ToVuKhoiNguyen/Smart-Crop-Care-System/Nháp.docx

Hệ thống giám sát và điều khiển nông nghiệp sử dụng năng lượng mặt trời và IoT hoạt động dựa trên hai nguồn năng lượng chính: adapter cấp nguồn cho Gateway và pin mặt trời cung cấp năng lượng cho các node cảm biến và node điều khiển. Các node này sử dụng pin Li-ion 18650 được sạc qua mạch sạc CN3791 từ tấm pin mặt trời. Các thành phần tiêu thụ năng lượng chính là vi điều khiển ESP32, cảm biến, mô-đun LoRa, và OLED ở node cảm biến, cùng với relay ở node điều khiển. Hệ thống áp dụng chế độ deep sleep, giúp tiết kiệm năng lượng khi không hoạt động, giảm dòng tiêu thụ xuống dưới 3mA.

Node cảm biến tiêu thụ năng lượng qua các trạng thái như deep sleep (dưới 100 µA), đo đạc (20–80 mA), truyền tin LoRa (120–140 mA), và chờ ACK (10–20 mA), trong khi node điều khiển có mức tiêu thụ năng lượng cao hơn do hoạt động của relay, với dòng tiêu thụ lên đến 70–90 mA khi bật. Gateway là thành phần duy nhất sử dụng nguồn điện liên tục, với mức tiêu thụ ổn định từ 100–120 mA để duy trì hoạt động của các thành phần như ESP32, LoRa, và màn hình TFT.

Để tối ưu hóa năng lượng, hệ thống áp dụng các chiến lược như chế độ ngủ và chu kỳ đánh thức định kỳ, đồng thời điều chỉnh thời gian ngủ dựa trên mức điện áp còn lại của pin. Vào ban ngày, khi có ánh sáng mặt trời, chu kỳ ngủ của node cảm biến ngắn hơn (10 phút) để cập nhật dữ liệu thường xuyên, trong khi vào ban đêm hoặc khi pin yếu, chu kỳ ngủ sẽ dài hơn (30–60 phút). Hệ thống cũng sử dụng cơ chế tính toán phần trăm pin còn lại dựa trên điện áp đo được và điều chỉnh thời gian ngủ phù hợp để đảm bảo hoạt động ổn định trong điều kiện thiếu sáng.

Tấm pin mặt trời được chọn có công suất từ 3W đến 6W, đủ để sạc pin cho hệ thống ngay cả khi ánh sáng không lý tưởng. Pin lưu trữ cần có dung lượng từ 2700 mAh đến 3600 mAh để duy trì hoạt động trong khoảng 30 ngày không có ánh sáng mặt trời. Đối với việc gửi dữ liệu, mỗi node đánh thức định kỳ và gửi gói tin qua LoRa, đồng thời chờ phản hồi ACK từ Gateway. Nếu không nhận được phản hồi, node sẽ gửi lại tối đa 10 lần, cách nhau 5 giây. Cơ chế này giúp đảm bảo độ tin cậy trong truyền dữ liệu mà không gây lãng phí năng lượng quá mức.

Dựa trên Chương 3 và Chương 4 của tài liệu, dưới đây là nguyên lý hoạt động, thí nghiệm, kết quả và thảo luận theo định dạng báo cáo khoa học:

BÁO CÁO NGHIÊN CỨU: HỆ THỐNG CUNG CẤP VÀ QUẢN LÝ NĂNG LƯỢNG ĐIỆN CHO MẠNG ĐA CẢM BIẾN GIÁM SÁT CÂY TRỒNG SỬ DỤNG PIN MẶT TRỜI

I. Nguyên lý hoạt động

Hệ thống được thiết kế nhằm cung cấp và quản lý năng lượng hiệu quả cho mạng cảm biến giám sát cây trồng, sử dụng năng lượng mặt trời để đảm bảo hoạt động độc lập và bền vững. Nguyên lý hoạt động tập trung vào việc tối ưu hóa tiêu thụ năng lượng thông qua quản lý nguồn cấp, các chế độ hoạt động của vi điều khiển và chiến lược truyền nhận dữ liệu.

1. Cung cấp năng lượng bằng pin mặt trời:
  - Nguồn cấp: Các node cảm biến và node điều khiển hoạt động độc lập bằng pin sạc Li-ion 18650, được nạp điện từ tấm pin mặt trời đơn tinh thể (công suất tối đa khoảng 4.08W, điện áp ra 6-7V) thông qua mạch sạc CN3791 tích hợp MPPT phần cứng. Gateway sử dụng nguồn adapter 12V liên tục.
  - Chuyển đổi nguồn: Để tối ưu hiệu suất, các bộ ổn áp tuyến tính (LDO) như RT9080 và IC TLV62569 được lựa chọn cho node cảm biến nhờ dòng tĩnh thấp và hiệu suất cao. Node điều khiển sử dụng MP2451 và 7805.
  - Bảo vệ pin: Mạch bảo vệ DW01A và FS8205 được tích hợp để chống xả quá mức, quá dòng và ngắn mạch cho pin Li-ion, đảm bảo tuổi thọ và an toàn cho hệ thống.
2. Phân tích và tối ưu tiêu thụ năng lượng theo trạng thái hoạt động:
  - Các trạng thái hoạt động: Node cảm biến có bốn giai đoạn chính: ngủ sâu (deep sleep), đo lường, truyền tin (Tx) và chờ xác nhận (Rx). Node điều khiển tương tự nhưng có thêm giai đoạn kích hoạt tải (relay).
  - Tiết kiệm năng lượng:
    - Deep sleep: ESP32 được đưa vào chế độ ngủ sâu, chỉ duy trì bộ đếm thời gian thực (RTC) để đánh thức. Mức tiêu thụ dòng điện trong chế độ này được giảm xuống dưới 100 µA nhờ việc sử dụng MOSFET để ngắt hoàn toàn nguồn cấp cho các thiết bị ngoại vi như cảm biến, module LoRa, OLED và thẻ nhớ SD khi không sử dụng.
    - Quản lý tải: Relay trong node điều khiển (tiêu thụ 70-90 mA khi hoạt động) được thiết kế để chỉ bật trong thời gian ngắn và tự động tắt nếu không có lệnh tiếp theo, tránh hao phí năng lượng không cần thiết.
  - Lựa chọn thời gian ngủ và chu kỳ đánh thức:
    - Điều chỉnh linh hoạt: Chu kỳ đánh thức của node cảm biến không cố định mà được điều chỉnh động theo điều kiện ánh sáng và mức pin còn lại.
    - Ban ngày: Khi có ánh sáng mặt trời và pin được sạc, chu kỳ ngủ ngắn (khoảng 10 phút) được áp dụng để cập nhật dữ liệu thường xuyên hơn.
    - Ban đêm/Pin yếu: Khi trời tối hoặc pin yếu, chu kỳ ngủ được kéo dài (30-60 phút) để tiết kiệm năng lượng, do các thông số môi trường thường ổn định hơn. Phần trăm pin được ước lượng dựa trên điện áp pin.
3. Cân đối tần suất gửi dữ liệu và độ tin cậy truyền nhận:
  - Truyền nhận LoRa: Các node giao tiếp với Gateway qua công nghệ LoRa, hoạt động theo mô hình master-slave. Node cảm biến đánh thức định kỳ để đo và gửi dữ liệu.
  - Cơ chế Retry-Timeout: Để tăng độ tin cậy do khả năng mất gói tin của LoRa, node cảm biến sẽ chờ phản hồi ACK từ Gateway sau khi gửi gói tin. Nếu không nhận được ACK trong khoảng thời gian timeout (1-5 giây), node sẽ gửi lại gói tin (tối đa 10 lần, mỗi lần cách nhau 5 giây).
  - Chế độ ngủ tức thì: Nếu nhận được ACK hợp lệ, node sẽ chuyển ngay sang deep sleep để tiết kiệm năng lượng. Nếu sau 10 lần gửi lại vẫn không nhận được ACK, node sẽ ghi nhận lỗi và chuyển sang chế độ ngủ để tránh lãng phí năng lượng.
4. Kiến trúc hệ thống và lập trình:
  - Hệ thống sử dụng vi điều khiển ESP32 cho tất cả các node và Gateway.
  - Giao tiếp không dây tầm xa, tiết kiệm năng lượng LoRa được sử dụng giữa các node và Gateway.
  - Gateway kết nối với nền tảng ERa IoT qua Wi-Fi để giám sát và điều khiển từ xa.
  - Việc áp dụng hệ điều hành thời gian thực (RTOS) giúp phân tách và xử lý song song các tác vụ (đọc cảm biến, truyền nhận, điều khiển, quản lý năng lượng), nâng cao hiệu suất và khả năng phản hồi.

II. Thí nghiệm

Để kiểm chứng hiệu quả của hệ thống, các thí nghiệm được thực hiện qua ba giai đoạn chính: chế tạo phần cứng, đánh giá tiêu thụ năng lượng và triển khai thực nghiệm ngoài trời.

1. Chế tạo phần cứng:
  - Thiết kế mạch: Sơ đồ nguyên lý và layout mạch in cho node cảm biến, node điều khiển và Gateway được thiết kế bằng phần mềm Altium Designer.
  - Hàn mạch: Các linh kiện dán (RT9080, INA226, MOSFET, tụ trở 0805) và linh kiện xuyên lỗ (module ESP32-WROOM, LoRa RA-02, jack GX16/GX12, relay) được hàn thủ công. Các đường dẫn dòng cao được tăng bề rộng và hàn thêm dây đồng để tránh sụt áp. Mạch Gateway được tái sử dụng từ phiên bản thử nghiệm của node cảm biến với các điều chỉnh phù hợp.
  - Kiểm thử chức năng: Sau khi hàn, từng khối chức năng của mạch (nguồn, ESP32, LoRa, cảm biến, relay, màn hình cảm ứng, thẻ nhớ, Wi-Fi) được kiểm tra độc lập trong phòng thí nghiệm để đảm bảo hoạt động ổn định.
  - Chế tạo vỏ hộp: Các vỏ bảo vệ riêng biệt cho node cảm biến, node điều khiển và Gateway được thiết kế 3D bằng SolidWorks và in bằng công nghệ in 3D (vật liệu PLA hoặc ABS). Vỏ hộp được thiết kế với các khe thoát dây, lỗ thông gió, đế gắn pin mặt trời và nắp chống nước/bụi (IP54).
2. Đánh giá cải tiến tiêu thụ năng lượng:
  - Phương pháp: Đo dòng điện tiêu thụ của node cảm biến ở nhiều trạng thái hoạt động (tải tối đa, đọc cảm biến, gửi LoRa, nhàn rỗi, deep sleep) cho cả phiên bản mạch thử nghiệm ban đầu và phiên bản mạch đã tối ưu hóa.
  - Mục tiêu: So sánh mức giảm công suất tiêu thụ thực tế sau khi áp dụng các kỹ thuật tối ưu hóa phần cứng và phần mềm.
3. Triển khai thực nghiệm ngoài trời:
  - Bố trí: Hệ thống được triển khai liên tục trong gần 2 tuần tại một khu vực vườn.
    - Node cảm biến: Hai node cảm biến được đặt ở hai vị trí khác nhau trong vườn. Node 1 gắn trên thân cây (đo nhiệt độ, độ ẩm, ánh sáng). Node 2 đặt gần vườn hơn (đo EC, pH, độ ẩm đất). Cả hai node đều sử dụng vỏ in 3D và tấm pin mặt trời mini để tự cấp nguồn.
    - Node điều khiển: Đặt trong hộp nhựa kín ở góc vườn, kết nối với hệ thống bơm nước và bơm dinh dưỡng, nhận lệnh từ Gateway qua LoRa.
    - Gateway: Cố định trên cột bê tông cao 1.5m gần nhà, cấp nguồn bằng adapter 12V, tích hợp màn hình cảm ứng TFT 2.8 inch.
  - Mục tiêu: Đánh giá độ ổn định hệ thống trong điều kiện thực tế (nắng, mưa, sương, độ ẩm cao), khả năng truyền nhận LoRa tầm xa, độ bền của vỏ hộp, và hiệu quả của hệ thống cấp nguồn pin mặt trời, cũng như khả năng điều khiển tưới tự động.

III. Kết quả

1. Kết quả chế tạo phần cứng:
  - Mạch chức năng: Các khối chức năng chung (nguồn, ESP32, LoRa) hoạt động ổn định. Mạch điều khiển relay bằng vi điều khiển ổn định, tuy nhiên điều khiển bằng nút bấm thủ công vẫn còn nhiễu điện từ. Mạch cảm biến (I2C, UART, RS485) và sạc pin mặt trời ổn định. Gateway có màn hình cảm ứng nhạy, giao tiếp thẻ nhớ và Wi-Fi ổn định. Giao tiếp LoRa song song với nhiều node tương đối ổn định nhưng vẫn có mất gói tin.
  - Vỏ hộp: Các vỏ hộp in 3D được lắp ráp hoàn chỉnh, không xuất hiện cong vênh, rạn nứt hoặc thấm nước sau 2 tuần triển khai ngoài trời, cho thấy khả năng chịu đựng tốt trước thay đổi nhiệt độ và độ ẩm.
2. Kết quả cải tiến tiêu thụ năng lượng so với phiên bản thử nghiệm:
  - Phiên bản mạch cảm biến tối ưu hóa cho thấy sự cải thiện đáng kể về hiệu suất tiêu thụ năng lượng:
    - Tải tối đa: Công suất giảm từ 1795.0 mW xuống 614.1 mW (giảm ~65.8%).
    - Đọc cảm biến: Công suất giảm từ 642.1 mW xuống 326.5 mW (giảm ~49.2%).
    - Gửi LoRa: Công suất giảm từ 452.3 mW xuống 386.5 mW (giảm ~14.5%).
    - Nhàn rỗi: Công suất giảm từ 537.6 mW xuống 254.0 mW (giảm ~52.7%).
    - Deep sleep: Mạch mới tiêu thụ chỉ khoảng 11.0 mW.
  - Những cải tiến này là nhờ việc tắt ngoại vi không cần thiết và tối ưu phần mềm, giúp rút ngắn thời gian hoạt động ở mức cao và duy trì node trong trạng thái tiêu thụ thấp phần lớn thời gian.
3. Kết quả triển khai thực nghiệm ngoài trời:
  - Độ ổn định: Hệ thống vận hành liên tục ổn định trong gần 2 tuần dưới các điều kiện môi trường thực tế như nắng gắt, mưa nhỏ, sương đêm và độ ẩm cao. Không xảy ra hiện tượng reset ngẫu nhiên hoặc mất nguồn kéo dài.
  - Hiệu suất pin và sạc mặt trời:
    - Cả hai node cảm biến đều duy trì hoạt động liên tục mà không bị cạn pin hoàn toàn.
    - Mức pin dao động theo chu kỳ ngày-đêm, giảm nhẹ vào ngày nhiều mây hoặc hoạt động cao, và tăng lên gần 100% vào những ngày nắng tốt (ví dụ: 4/5 đến 7/5), cho thấy hiệu quả sạc của hệ thống pin mặt trời.
    - Cơ chế điều chỉnh thời gian ngủ theo điện áp pin và thời gian trong ngày hoạt động hiệu quả.
    - Node cảm biến 1 tiêu thụ trung bình 295.92 mWh/ngày, với dung lượng pin 11100 mWh, ước tính có thể hoạt động liên tục 37.5 ngày khi không sạc. Node cảm biến 2 tiêu thụ trung bình 533.77 mWh/ngày, ước tính hoạt động 20.8 ngày. Sự khác biệt này do số lượng cảm biến, cường độ tín hiệu LoRa và tần suất hoạt động khác nhau.
  - Chức năng điều khiển và giao tiếp: Hệ thống bơm và node điều khiển hoạt động bình thường, relay kích hoạt chính xác theo lệnh từ Gateway. Kết nối LoRa giữa các node và Gateway duy trì tốt, không có trường hợp mất kết nối kéo dài hoặc lỗi gói tin vượt quá giới hạn retry. Màn hình cảm ứng trên Gateway hiển thị đầy đủ và phản hồi nhanh chóng.

IV. Thảo luận

Kết quả thực nghiệm đã khẳng định tính khả thi và hiệu quả của hệ thống giám sát nông nghiệp thông minh sử dụng năng lượng mặt trời và mạng đa cảm biến.

1. Hiệu quả tối ưu năng lượng: Sự giảm đáng kể về công suất tiêu thụ ở tất cả các trạng thái hoạt động (đặc biệt là deep sleep chỉ 11 mW và giảm 66% công suất tải tối đa) là minh chứng rõ ràng cho các kỹ thuật tối ưu hóa phần cứng và phần mềm. Việc sử dụng MOSFET để ngắt nguồn ngoại vi, LDO dòng tĩnh thấp và chế độ ngủ động của ESP32 đã thành công trong việc kéo dài thời gian hoạt động độc lập của các node cảm biến lên đến nhiều tuần mà không cần sạc. Cơ chế điều chỉnh chu kỳ ngủ theo điều kiện ánh sáng và mức pin là chìa khóa để duy trì hoạt động bền vững, đặc biệt trong điều kiện thời tiết khắc nghiệt hoặc ban đêm.
2. Độ tin cậy truyền thông LoRa: Việc áp dụng công nghệ LoRa với cơ chế Retry-Timeout và ACK đã cải thiện đáng kể độ tin cậy trong giao tiếp không dây. Mặc dù vẫn ghi nhận một số gói tin bị mất trong môi trường thực địa có vật cản, nhưng cơ chế này đã đảm bảo dữ liệu vẫn được truyền đi thành công sau một số lần gửi lại, duy trì tính toàn vẹn của thông tin. RTOS cũng đóng vai trò quan trọng trong việc quản lý các tác vụ truyền nhận song song, giúp hệ thống không bị "treo" khi chờ phản hồi.
3. Thiết kế phần cứng và vỏ hộp: Các mạch được chế tạo và vỏ hộp in 3D được thiết kế riêng biệt đã chứng tỏ khả năng bảo vệ tốt các linh kiện điện tử khỏi các yếu tố môi trường như nắng, mưa, bụi, độ ẩm. Sự bền bỉ của vỏ hộp là yếu tố then chốt cho việc triển khai dài hạn trong môi trường nông nghiệp khắc nghiệt, góp phần nâng cao tính chuyên nghiệp và giảm chi phí bảo trì.
4. Chức năng Gateway: Gateway hoạt động hiệu quả như một trung tâm điều phối, không chỉ thu thập và hiển thị dữ liệu mà còn đưa ra quyết định điều khiển tự động dựa trên các thông số môi trường. Giao diện cảm ứng cục bộ và kết nối với nền tảng ERa IoT đã cung cấp khả năng giám sát và điều khiển linh hoạt, đáp ứng nhu cầu của người dùng tại chỗ và từ xa.

Chương này phân tích chi tiết về hệ thống năng lượng trong hệ thống giám sát và điều khiển nông nghiệp sử dụng IoT, với hai nguồn cung cấp năng lượng chính: pin mặt trời và adapter cho Gateway. Mục tiêu là đảm bảo các node cảm biến và điều khiển hoạt động liên tục, tiết kiệm năng lượng, đặc biệt trong điều kiện không có nguồn điện lưới.

1. Phân tích năng lượng đầu vào – đầu ra của từng node

- Node cảm biến sử dụng pin Li-ion 18650, được sạc qua mạch sạc CN3791 từ pin mặt trời. Các bộ chuyển đổi nguồn cung cấp điện áp cho các thành phần như ESP32, cảm biến, LoRa, OLED. Hệ thống sử dụng chế độ deep sleep và MOSFET để giảm tiêu thụ năng lượng, chỉ tiêu thụ dưới 3mA trong trạng thái nghỉ.
- Node điều khiển cũng có cấu trúc tương tự nhưng tiêu thụ năng lượng cao hơn do thêm relay cơ học. Relay chỉ bật trong thời gian ngắn và tắt tự động để tiết kiệm năng lượng.
- Gateway sử dụng nguồn cấp ngoài ổn định 12V, chuyển đổi thành 3.3V và 5V để cấp cho các thành phần như ESP32, LoRa, màn hình TFT, thẻ nhớ SD. Dòng tiêu thụ ổn định khoảng 100–120mA.

2. Phân tích tiêu thụ năng lượng theo trạng thái hoạt động

Node cảm biến có bốn trạng thái hoạt động:

- Deep sleep (tiêu thụ ít nhất, dưới 100µA).
- Đo lường (tiêu thụ 20–80mA tùy theo cảm biến).
- Truyền tin (tiêu thụ tối đa 120–140mA trong lúc truyền dữ liệu qua LoRa).
- Chờ ACK (tiêu thụ 10–20mA khi nhận phản hồi). Node điều khiển có chế độ tương tự, nhưng với mức tiêu thụ cao hơn khi relay bật.

3. Lựa chọn công suất pin mặt trời và dung lượng pin

Để đảm bảo năng lượng cho các node, công suất tấm pin mặt trời cần lớn hơn mức tiêu thụ tối đa của hệ thống (1.764W). Với hiệu suất thực tế 70–80%, công suất tấm pin tối thiểu là 2.52W. Tấm pin mặt trời đơn tinh thể (4.08W) được chọn, cung cấp năng lượng đủ cho các node hoạt động liên tục. Dung lượng pin lưu trữ cần đủ để duy trì hoạt động trong 30 ngày không có nắng, với dung lượng tối thiểu khoảng 2700–3600mAh, sử dụng 2–3 cell pin Li-ion 18650.

4. Lựa chọn thời gian ngủ và chu kỳ đánh thức

Để tiết kiệm năng lượng, các node cảm biến sử dụng cơ chế đánh thức định kỳ qua RTC nội bộ của ESP32, kết hợp với chức năng đo dung lượng pin và thời gian trong ngày. Chu kỳ ngủ được điều chỉnh linh hoạt theo mức điện áp của pin:

- Ban ngày (sử dụng chu kỳ ngủ 10 phút, giúp cập nhật dữ liệu thường xuyên).
- Ban đêm (kéo dài chu kỳ ngủ từ 30 đến 60 phút để tiết kiệm năng lượng, tùy thuộc vào mức điện áp còn lại của pin).

5. Cân đối tần suất gửi dữ liệu và độ tin cậy truyền nhận

Tần suất gửi dữ liệu ảnh hưởng trực tiếp đến tiêu thụ năng lượng và độ tin cậy của hệ thống. Sau khi gửi gói tin, node sẽ chờ phản hồi ACK từ Gateway. Nếu không nhận được, node sẽ gửi lại tối đa 10 lần, cách nhau 5 giây. Điều này giúp giảm tỷ lệ va chạm sóng LoRa và cải thiện độ tin cậy truyền nhận.

Chương này tổng hợp các yếu tố liên quan đến quản lý năng lượng trong hệ thống IoT nông nghiệp, với các giải pháp tối ưu để đảm bảo hoạt động liên tục và tiết kiệm năng lượng, đặc biệt trong môi trường không có nguồn điện lưới.

Đoạn văn bạn chia sẻ miêu tả chi tiết về kết quả cải tiến tiêu thụ năng lượng và triển khai thực nghiệm ngoài trời của hệ thống cảm biến tự động cho nông nghiệp. Sau đây là một số điểm nổi bật và quan trọng trong nghiên cứu này:

1. Cải tiến Tiêu thụ Năng Lượng:

- Cải thiện hiệu quả tiêu thụ năng lượng: Việc tối ưu hóa mạch phần cứng, sử dụng linh kiện tiêu thụ ít năng lượng và kiểm soát hoạt động của từng khối chức năng đã giúp giảm công suất tiêu thụ ở tất cả các trạng thái hoạt động.
- Giảm công suất tiêu thụ: Công suất tiêu thụ tại chế độ tải tối đa giảm từ 1.8W xuống 0.6W, tức giảm gần 66%. Điều này đã giúp tăng thời gian hoạt động của hệ thống mà không cần sạc lại thường xuyên.
- Chế độ ngủ sâu: Hệ thống có thể tiết kiệm năng lượng đáng kể khi ở chế độ deep sleep (chỉ tiêu thụ 11mW), giúp kéo dài thời gian hoạt động mà không cần can thiệp.
- Tự động điều khiển nguồn: Phần mềm điều phối chính xác các khối chức năng như LoRa chỉ bật khi có tín hiệu ACK cần gửi, từ đó tối ưu hóa thời gian hoạt động của hệ thống.

2. Triển khai Thực nghiệm ngoài trời:

- Hệ thống bao gồm các thành phần chính: Các node cảm biến đo nhiệt độ, độ ẩm, ánh sáng, pH, EC... được lắp đặt trong môi trường thực tế (khu vực trồng trọt) và kết nối qua LoRa với gateway trung tâm.
- Điều kiện môi trường: Các node cảm biến tiếp xúc trực tiếp với môi trường nắng, mưa, sương đêm, độ ẩm cao, nhưng vẫn hoạt động ổn định mà không bị mất nguồn hay reset.
- Quản lý nguồn năng lượng: Hệ thống sử dụng pin mặt trời để cấp nguồn cho các node cảm biến. Sự dao động điện áp của pin được ghi nhận và cho thấy hệ thống có khả năng duy trì hoạt động ổn định, ngay cả trong những ngày trời nhiều mây.
- Kết quả tiêu thụ năng lượng thực tế: Node cảm biến 1 tiêu thụ khoảng 4054.17 mWh trong 13.7 ngày, trong khi node cảm biến 2 tiêu thụ 3805.82 mWh trong 7.13 ngày. Cả hai node vẫn duy trì được hoạt động liên tục mà không bị ngắt kết nối.

3. Đánh giá độ ổn định và bền vững:

- Vỏ hộp in 3D: Vỏ hộp của các node cảm biến không bị cong vênh, rạn nứt hay thấm nước sau 2 tuần thử nghiệm ngoài trời, chứng tỏ tính bền vững và khả năng chống chịu tốt với điều kiện thời tiết khắc nghiệt.
- Hệ thống điều khiển và bơm: Các relay điều khiển bơm nước và dung dịch dinh dưỡng hoạt động chính xác, không gặp phải tình trạng bị kẹt hay nhiễu tín hiệu từ môi trường.
- Kết nối không dây ổn định: Kết nối LoRa giữa các node và Gateway vẫn duy trì tốt, không có hiện tượng mất kết nối kéo dài hay lỗi gói tin không nhận được ACK.

4. Hiệu quả sạc pin mặt trời:

- Sự ảnh hưởng của điều kiện thời tiết: Mức độ dao động của điện áp pin có sự thay đổi theo điều kiện thời tiết (mưa, nắng), nhưng hệ thống vẫn duy trì khả năng sạc và cấp nguồn hiệu quả. Node cảm biến có thể hoạt động liên tục mà không cần sạc lại khi có nắng, và thậm chí đạt mức pin gần 100%.

5. Tương lai và Tiềm năng phát triển:

- Quản lý năng lượng thông minh: Các cải tiến về quản lý năng lượng giúp tăng thời gian hoạt động của hệ thống mà không cần can thiệp, mở ra tiềm năng phát triển các hệ thống cảm biến tự động cho nông nghiệp, đồng thời tiết kiệm chi phí bảo trì và sạc lại.
- Ứng dụng trong nông nghiệp thông minh: Hệ thống này có thể mở rộng và áp dụng cho các mô hình nông nghiệp thông minh khác, đặc biệt là những nơi cần tự động hóa trong việc giám sát môi trường và tưới tiêu cây trồng.

Kết quả này không chỉ chứng tỏ sự cải tiến về hiệu quả năng lượng mà còn phản ánh khả năng ứng dụng thực tế của hệ thống trong môi trường nông nghiệp, mang lại hiệu quả bền vững.

Đoạn văn bạn chia sẻ có thể được chia thành các phần nguyên lý hoạt động, thử nghiệm, kết quả và thảo luận như sau:

1. Nguyên lý Hoạt động

Cải tiến Tiêu thụ Năng Lượng

- Tối ưu hóa mạch phần cứng: Sử dụng các linh kiện tiêu thụ ít năng lượng và điều khiển các khối chức năng của hệ thống nhằm giảm tiêu thụ năng lượng trong mọi trạng thái hoạt động.
- Chế độ Deep Sleep: Hệ thống sử dụng chế độ ngủ sâu để tiết kiệm năng lượng khi không cần hoạt động. Trong chế độ này, hệ thống chỉ tiêu thụ 11mW, giúp kéo dài thời gian hoạt động mà không cần can thiệp.
- Tự động điều khiển nguồn: Phần mềm điều phối các khối chức năng, như LoRa, chỉ bật khi có tín hiệu ACK cần gửi, tối ưu hóa thời gian hoạt động.

Quản lý nguồn năng lượng

- Sử dụng Pin Mặt Trời: Hệ thống sử dụng năng lượng từ pin mặt trời để cấp nguồn cho các node cảm biến. Pin mặt trời giúp cung cấp nguồn năng lượng liên tục cho hệ thống mà không phụ thuộc vào nguồn điện lưới.
- Chu kỳ ngủ và đánh thức: Các node cảm biến sử dụng chu kỳ ngủ linh hoạt để tiết kiệm năng lượng, ví dụ như ban ngày ngủ 10 phút và ban đêm từ 30 đến 60 phút tùy theo mức điện áp pin.

2. Thử nghiệm ngoài trời

Thiết lập hệ thống

- Các node cảm biến: Hệ thống bao gồm các node cảm biến đo nhiệt độ, độ ẩm, ánh sáng, pH, EC... Những node này được lắp đặt trong môi trường thực tế (khu vực trồng trọt) và kết nối qua LoRa với gateway trung tâm.
- Điều kiện môi trường: Các node cảm biến được đặt trong môi trường khắc nghiệt, chịu nắng, mưa, sương đêm và độ ẩm cao. Tuy nhiên, các node vẫn hoạt động ổn định mà không bị mất nguồn hay reset.

Quản lý nguồn năng lượng và Sạc Pin Mặt Trời

- Sự dao động điện áp: Điện áp của pin mặt trời dao động tùy thuộc vào điều kiện thời tiết (nắng, mưa), nhưng hệ thống vẫn duy trì được khả năng sạc và cấp nguồn hiệu quả cho các node cảm biến.
- Thời gian hoạt động liên tục: Các node cảm biến có thể hoạt động liên tục mà không cần sạc lại khi có nắng, và đạt mức pin gần 100% trong điều kiện thời tiết tốt.

3. Kết quả

Tiêu thụ năng lượng

- Node cảm biến 1: Tiêu thụ khoảng 4054.17 mWh trong 13.7 ngày.
- Node cảm biến 2: Tiêu thụ khoảng 3805.82 mWh trong 7.13 ngày.
- Cả hai node đều duy trì hoạt động liên tục mà không bị ngắt kết nối.

Đánh giá độ ổn định và bền vững

- Vỏ hộp in 3D: Vỏ hộp của các node cảm biến không bị cong vênh, rạn nứt hay thấm nước sau 2 tuần thử nghiệm ngoài trời, chứng tỏ tính bền vững và khả năng chống chịu tốt với điều kiện thời tiết khắc nghiệt.
- Hệ thống điều khiển và bơm: Các relay điều khiển bơm nước và dung dịch dinh dưỡng hoạt động chính xác, không gặp phải tình trạng bị kẹt hay nhiễu tín hiệu từ môi trường.
- Kết nối LoRa ổn định: Kết nối không dây giữa các node và Gateway duy trì tốt, không có hiện tượng mất kết nối kéo dài hay lỗi gói tin không nhận được ACK.

4. Thảo luận

Hiệu quả sạc pin mặt trời

- Ảnh hưởng của điều kiện thời tiết: Sự dao động của điện áp pin có thể thay đổi theo điều kiện thời tiết (mưa, nắng), nhưng hệ thống vẫn duy trì khả năng sạc và cấp nguồn ổn định cho các node cảm biến. Khi có nắng, các node có thể đạt mức pin gần 100%, đảm bảo hoạt động liên tục mà không cần sạc lại.

Tương lai và Tiềm năng phát triển

- Quản lý năng lượng thông minh: Các cải tiến về quản lý năng lượng giúp kéo dài thời gian hoạt động của hệ thống mà không cần can thiệp, mở ra tiềm năng phát triển các hệ thống cảm biến tự động cho nông nghiệp thông minh.
- Ứng dụng trong nông nghiệp thông minh: Hệ thống này có thể mở rộng và áp dụng cho các mô hình nông nghiệp thông minh, đặc biệt là những nơi cần tự động hóa trong việc giám sát môi trường và tưới tiêu cây trồng.

Tổng kết:

Kết quả nghiên cứu không chỉ chứng tỏ hiệu quả năng lượng của hệ thống mà còn minh chứng cho khả năng ứng dụng thực tế trong môi trường nông nghiệp. Các cải tiến về quản lý năng lượng giúp hệ thống hoạt động ổn định và bền vững mà không cần can thiệp thường xuyên, mang lại hiệu quả lâu dài cho các ứng dụng nông nghiệp thông minh.
