ToVuKhoiNguyen/Smart-Crop-Care-System/test/test_communicate/test_read_lora_config.cpp

#include <LoRa.h>
#include <SPI.h>
 
#define ss 5
#define rst 4
#define dio0 2
 
long getSignalBandwidth()
{
  byte bw = (readRegister(REG_MODEM_CONFIG_1) >> 4);

  switch (bw) {
    case 0: return 7.8E3;
    case 1: return 10.4E3;
    case 2: return 15.6E3;
    case 3: return 20.8E3;
    case 4: return 31.25E3;
    case 5: return 41.7E3;
    case 6: return 62.5E3;
    case 7: return 125E3;
    case 8: return 250E3;
    case 9: return 500E3;
  }

  return -1;
}

void setup() 
{
  Serial.begin(115200);
  while (!Serial);
  Serial.println("LoRa Receiver");
 
  LoRa.setPins(ss, rst, dio0);    //setup LoRa transceiver module
 
  while (!LoRa.begin(433E6))     //433E6 - Asia, 866E6 - Europe, 915E6 - North America
  {
    Serial.println(".");
    delay(500);
  }
  LoRa.setSyncWord(0xA5);
  Serial.println("LoRa Initializing OK!");
  byte bw = (readRegister(REG_MODEM_CONFIG_1) >> 4);
  Serial.print("Signal Bandwidth: "): Serial.println(getSignalBandwidth());
  LoRa.get
}


 
void loop() 
{
    
}
