ToVuKhoiNguyen/Smart-Crop-Care-System/test/test_GPIO/test_soil_moisture.cpp

#include <Arduino.h>

void setup()
{
  // put your setup code here, to run once:
  pinMode(26, INPUT);
  Serial.begin(115200);
}

void loop()
{
  // put your main code here, to run repeatedly:
  Serial.println(digitalRead(26));
  delay(1000);
}
